Aeuda/ECE295_A3/README.md

# ECE295_A3
This repository hosts the design files, simulation results, and documentation for a sophisticated signal processing system for Team A3 in ECE295.
