Aeuda/ECE295_A3/M2/Untitled document.docx

Final schematic of band-pass Filter and Voltage Limiter:

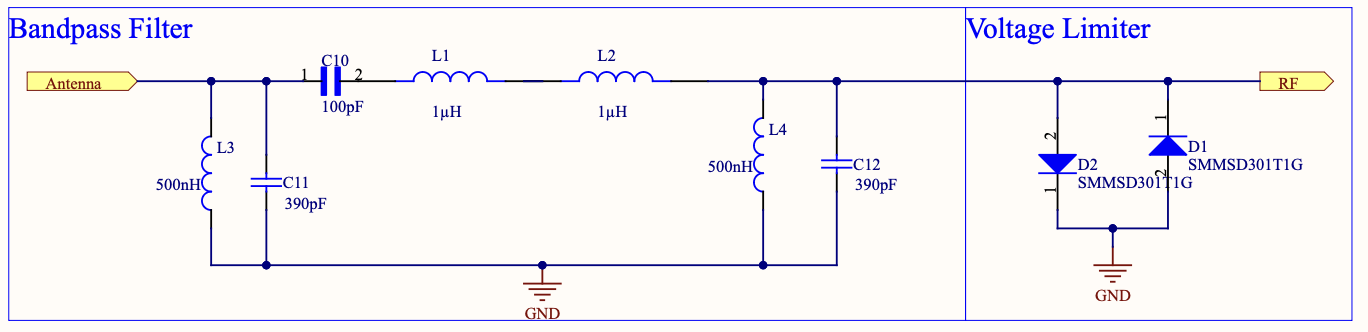
[picture p20: figure]

Final schematic of Gilbert Cell mixer and back up mixer IC for inphase and quadratuere:

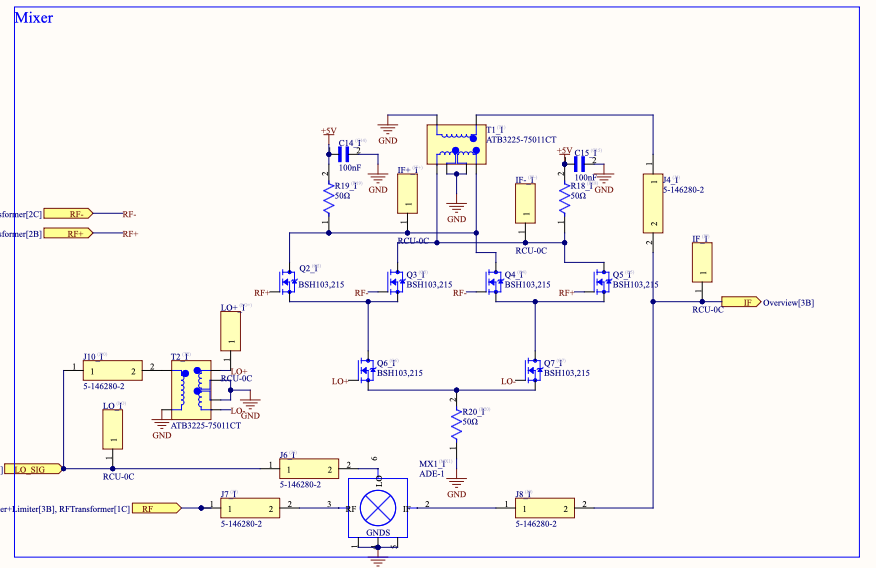
[picture p21: figure]
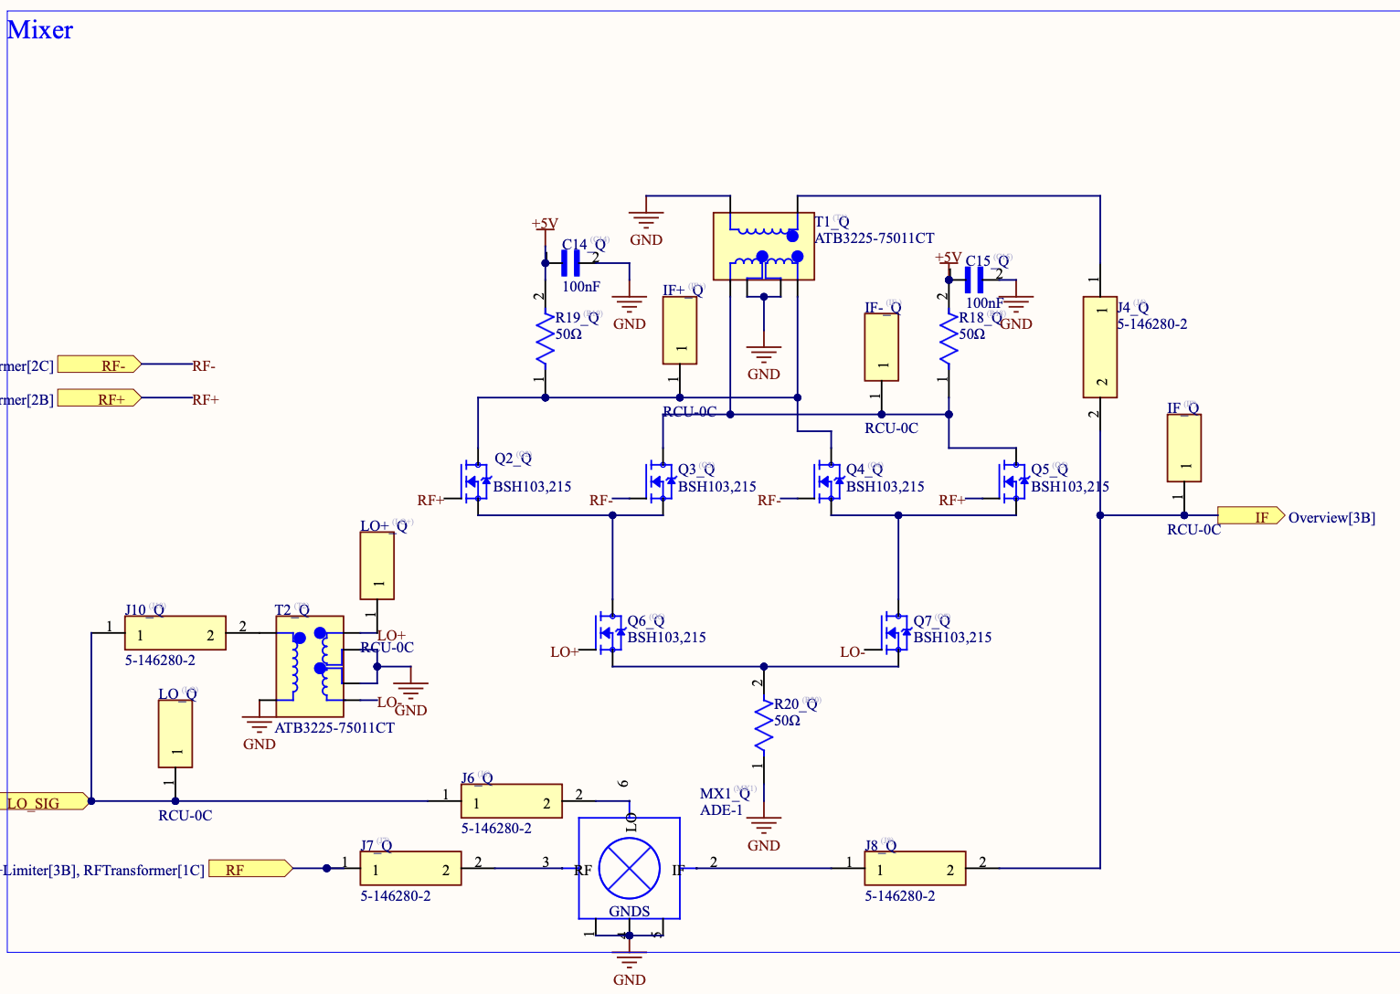
[picture p22: figure]

Final Schematic of low-pass filter and amplifier inphase and quadrature:

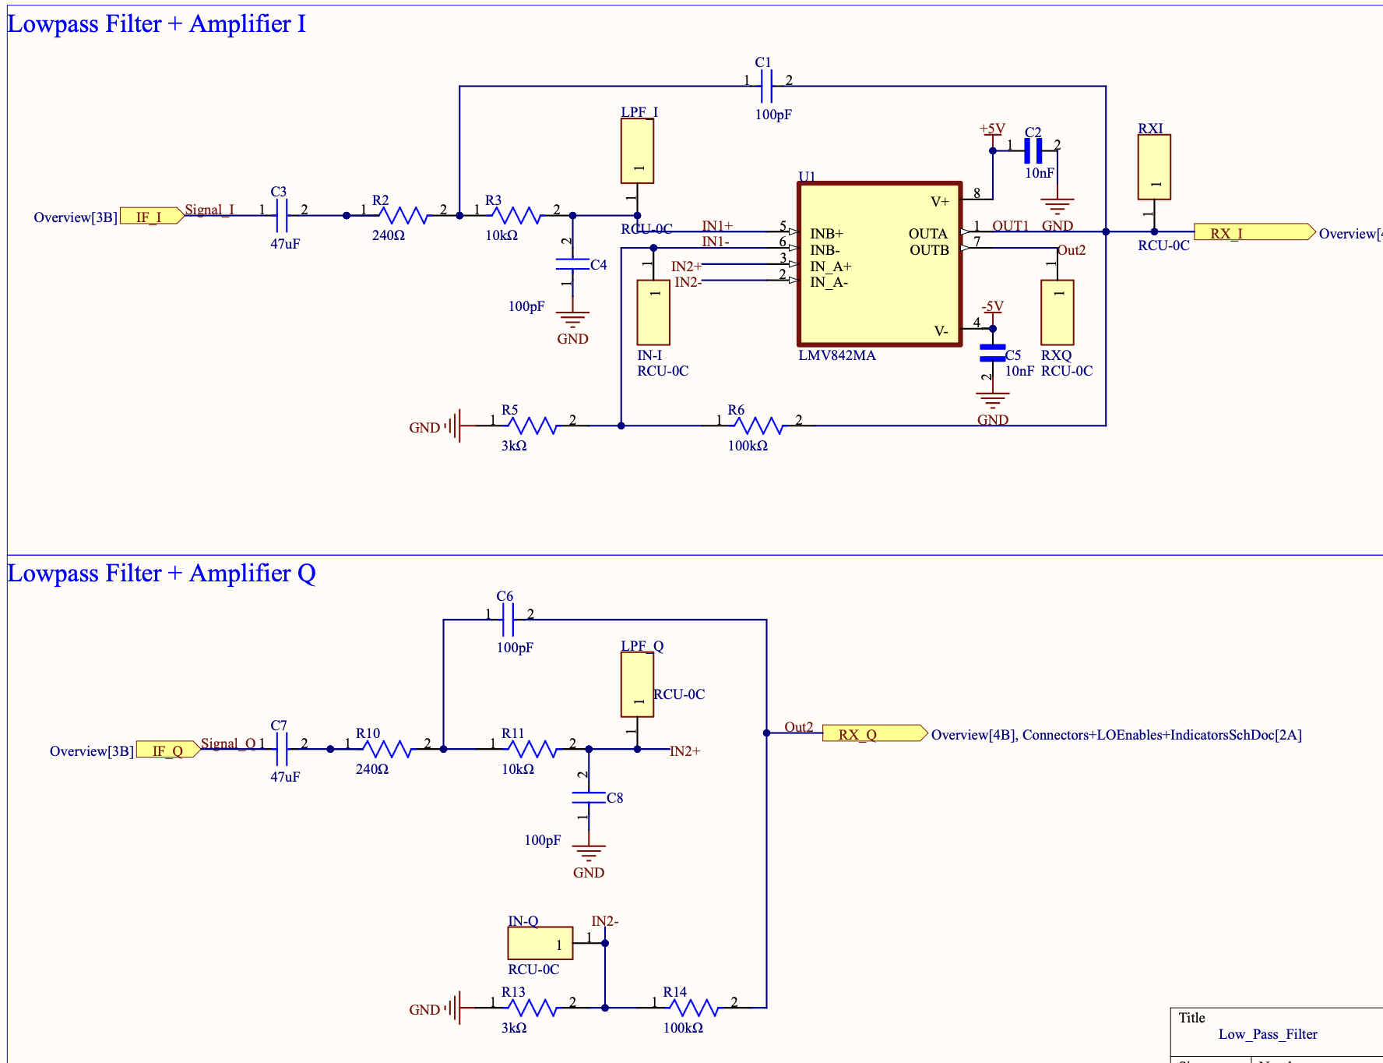
[picture p23: figure]

Final schematic of the connectors and other devices:

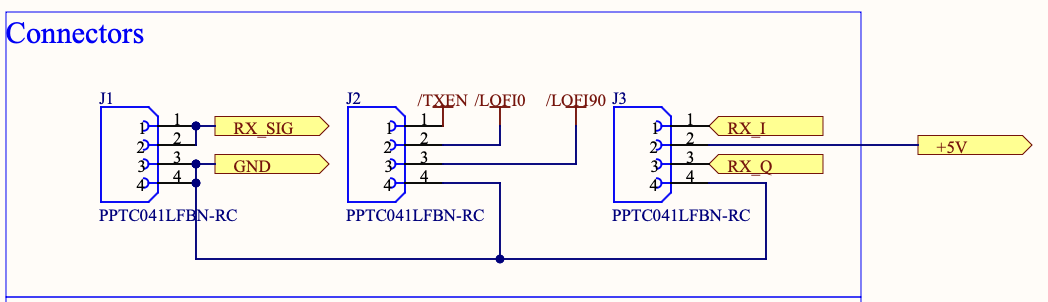
[picture p24: figure]
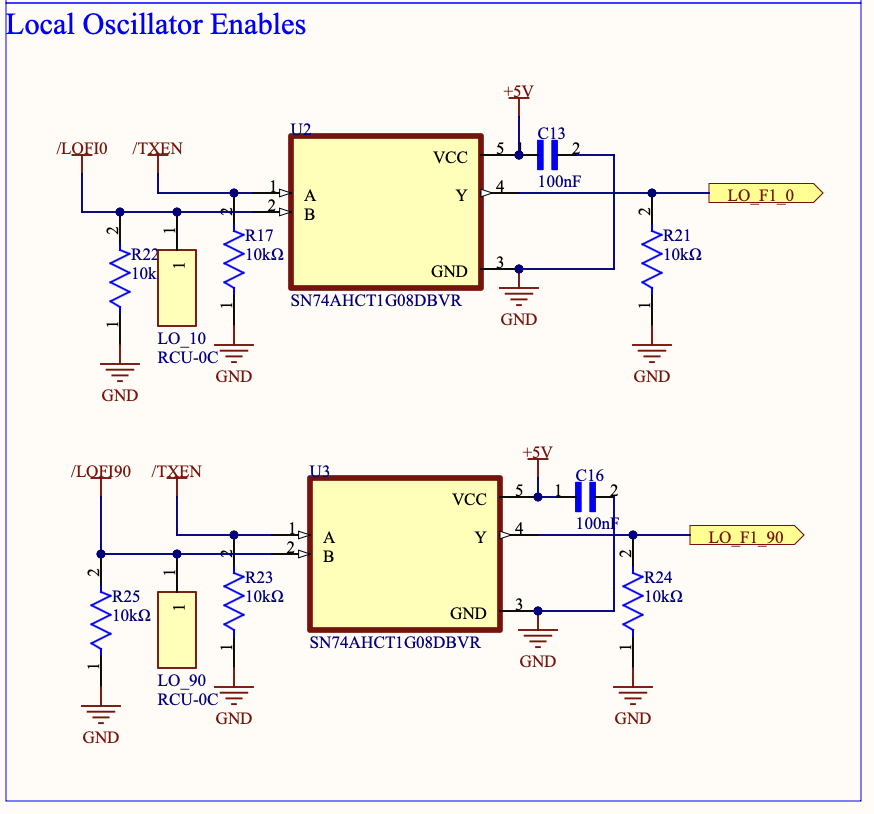
[picture p25: figure]
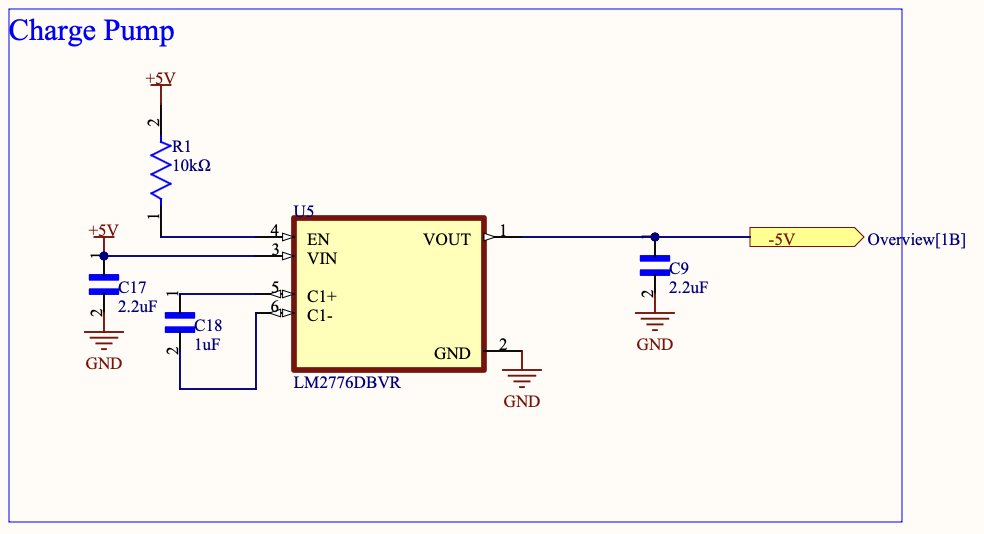
[picture p26: figure]
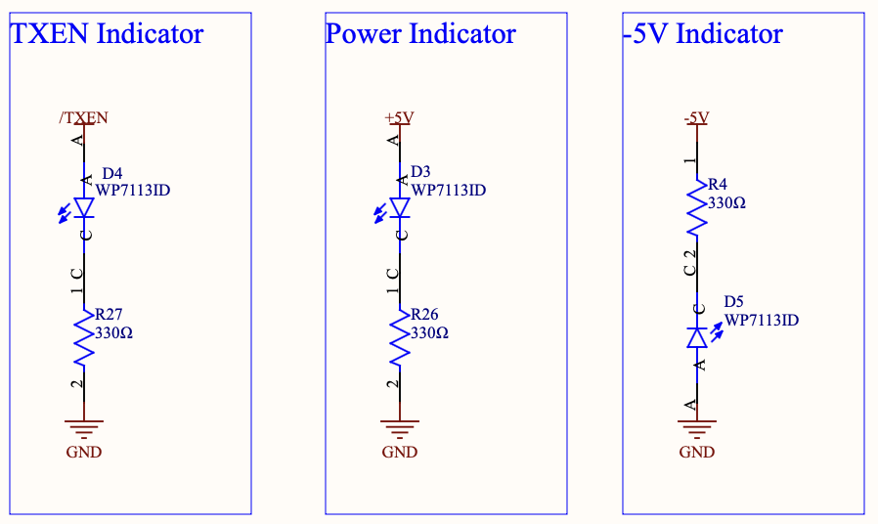
[picture p27: figure]

Final Layout design:

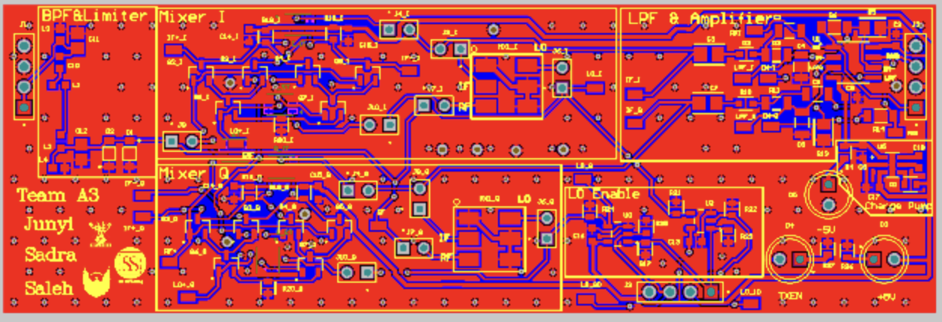
[picture p28: figure]
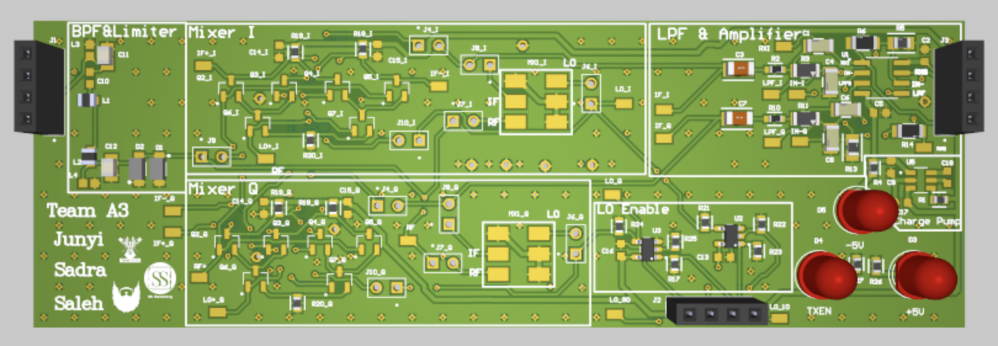
[picture p29: figure]
