Aeuda/ECE295_A3/M1/BOM.xlsx

Subsystem Section | Part Number | Component | Quantity | Unit Price | Cost | Digikey Link
Band-Pass Filter
 | HMLQ20161B-1R0MDR | 1uH Coil Inductor | 4 | $0.39 | $1.56 | https://www.digikey.ca/en/products/detail/delta-electronics-cyntec/HMLQ20161B-1R0MDR/9761420
 | CBR06C101F5GAC | 100pF Capacitor | 2 | $1.42 | $2.84 | https://www.digikey.ca/en/products/detail/kemet/CBR06C101F5GAC/7649445
 | VJ0805D391JXAQJHT | 390pF Capacitor | 4 | $0.95 | $3.80 | https://www.digikey.ca/en/products/detail/vishay-vitramon/VJ0805D391JXAQJHT/14292825
 | BRC1608TR50M6 | 500nH Coil Inductor | 4 | $0.42 | $1.68 | https://www.digikey.ca/en/products/detail/taiyo-yuden/BRC1608TR50M6/3479444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
Voltage Limiter
 | SMMSD301T1G | Schottky Diodes | 4 | $0.69 | $2.76 | https://www.digikey.ca/en/products/detail/onsemi/SMMSD301T1G/3062783
Mixer
 | BSH103,235 | NMOS | 16 | $0.56 | $8.96 | https://www.digikey.ca/en/products/detail/nexperia-usa-inc/BSH103-235/1155053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
 | ADE-1+ | RF mixer | 3 | $7.49 | $22.47 | https://www.digikey.ca/en/products/detail/mini-circuits/ADE-1/13927959
 | ATB3225-75011CT-T001 | transformer | 5 | $2.65 | $13.25 | https://www.digikey.ca/en/products/detail/tdk-corporation/ATB3225-75011CT-T001/3077895
 | CRCW060350R0FKEA | resistor 50 | 6 | $0.15 | $0.90 | https://www.digikey.ca/en/products/detail/vishay-dale/CRCW060350R0FKEA/5072766
 | CC0603KRX7R7BB104 | 0.1u cap | 4 | $0.14 | $0.56 | https://www.digikey.ca/en/products/detail/yageo/CC0603KRX7R7BB104/302822
 | 5-146280-2 | 2pin connector | 11 | $0.63 | $6.93 | https://www.digikey.ca/en/products/detail/te-connectivity-amp-connectors/5-146280-2/2275896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
 | S9001-ND | connector jumpers | 8 | $0.15 | $1.20 | https://www.digikey.ca/en/products/detail/sullins-connector-solutions/SPC02SYAN/76375?productid=76375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
Low-Pass Filter and Amplifier
 | 399-C0603X103K1RAC3316CT-ND | 10nF Capacitor | 4 | $0.57 | $2.28 | https://www.digikey.ca/en/products/detail/kemet/C0603X103K1RAC3316/10315782
 | C3216X6S0J476M160AB | 47uF Capacitor | 4 | $1.16 | $4.64 | https://www.digikey.ca/en/products/detail/tdk-corporation/C3216X6S0J476M160AB/2443489
 | 732-7887-1-ND | 100pF capacitor | 6 | $0.19 | $1.14 | https://www.digikey.ca/en/products/detail/würth-elektronik/885012008043/5453742
 | CRCW120610K0FKEA | 10kΩ Resistor | 4 | $0.15 | $0.60 | https://www.digikey.ca/en/products/detail/vishay-dale/CRCW120610K0FKEA/1176758
 | RT0603FRE07240RL | 240Ω Resistor | 4 | $0.15 | $0.60 | https://www.digikey.ca/en/products/detail/yageo/RT0603FRE07240RL/1075226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
 | RG2012P-302-B-T5 | 3kΩ Resistor | 5 | $0.32 | $1.60 | https://www.digikey.ca/en/products/detail/susumu/RG2012P-302-B-T5/1240739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
 | RT1206DRE07100KL | 100kΩ Resistor | 5 | $0.15 | $0.75 | https://www.digikey.ca/en/products/detail/yageo/RT1206DRE07100KL/1082291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
 | TLV6742IDR | IC Op amp | 3 | $1.76 | $5.28 | https://www.digikey.ca/en/products/detail/texas-instruments/TLV6742IDR/11502222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
Oscillator Enables
 | 296-1113-1-ND | AND gates | 4 | $0.60 | $2.40 | https://www.digikey.ca/en/products/detail/texas-instruments/SN74AHCT1G08DBVR/276757
 | RC0603FR-0710KL | 10K resistor | 8 | $0.15 | $1.20 | https://www.digikey.ca/en/products/detail/yageo/RC0603FR-0710KL/726880
 | A106145CT-ND | testing points | 22 | $0.30 | $6.60 | https://www.digikey.ca/en/products/detail/te-connectivity-amp-connectors/RCU-0C/2366048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
 | 754-1264-ND | LEDs | 5 | $0.52 | $2.60 | https://www.digikey.ca/en/products/detail/kingbright/WP7113ID/1747663
 | 490-GCM188L81H104MA57JCT-ND | 0.1 uf caps | 4 | $0.24 | $0.96 | https://www.digikey.ca/en/products/detail/murata-electronics/GCM188L81H104MA57J/13401872
 | 311-330GRCT-ND | 330 ohm resistor | 4 | $0.15 | $0.60 | https://www.digikey.ca/en/products/detail/yageo/RC0603JR-07330RL/726769
 | S1011EC-04-ND | Connectors Male | 5 | $0.19 | $0.95 | https://www.digikey.ca/en/products/detail/sullins-connector-solutions/PRPC004SAAN-RC/2775250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
Charge Pump
 | 296-43957-1-ND | Switched cap inverter | 2 | 1.66 | 3.32 | https://www.digikey.ca/en/products/detail/texas-instruments/LM2776DBVR/5356685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
 | 490-GCM188L81H104MA57JCT-ND | 2.2uF capacitor | 4 | 0.24 | 1.2 | https://www.digikey.ca/en/products/detail/murata-electronics/GCM188L81H104MA57J/13401872
 | 311-1343-1-ND | 1uF capacitor | 2 | 0.14 | 0.28 | https://www.digikey.ca/en/products/detail/yageo/CC0603ZRY5V9BB104/2103081
 | 311-10.0KHRCT-ND | 10K resistor 0603 | 2 | 0.15 | 0.3 | https://www.digikey.ca/en/products/detail/yageo/RC0603FR-0710KL/726880
 | A121525CT-ND | 330 ohm resisotr | 2 | 0.15 | 0.3 | https://www.digikey.ca/en/products/detail/te-connectivity-passive-product/CRG0603F330R/2380765
 |  |  |  | Total | $103.63
