Aeuda/ECE295_A3/M0/M0Plot.pdf

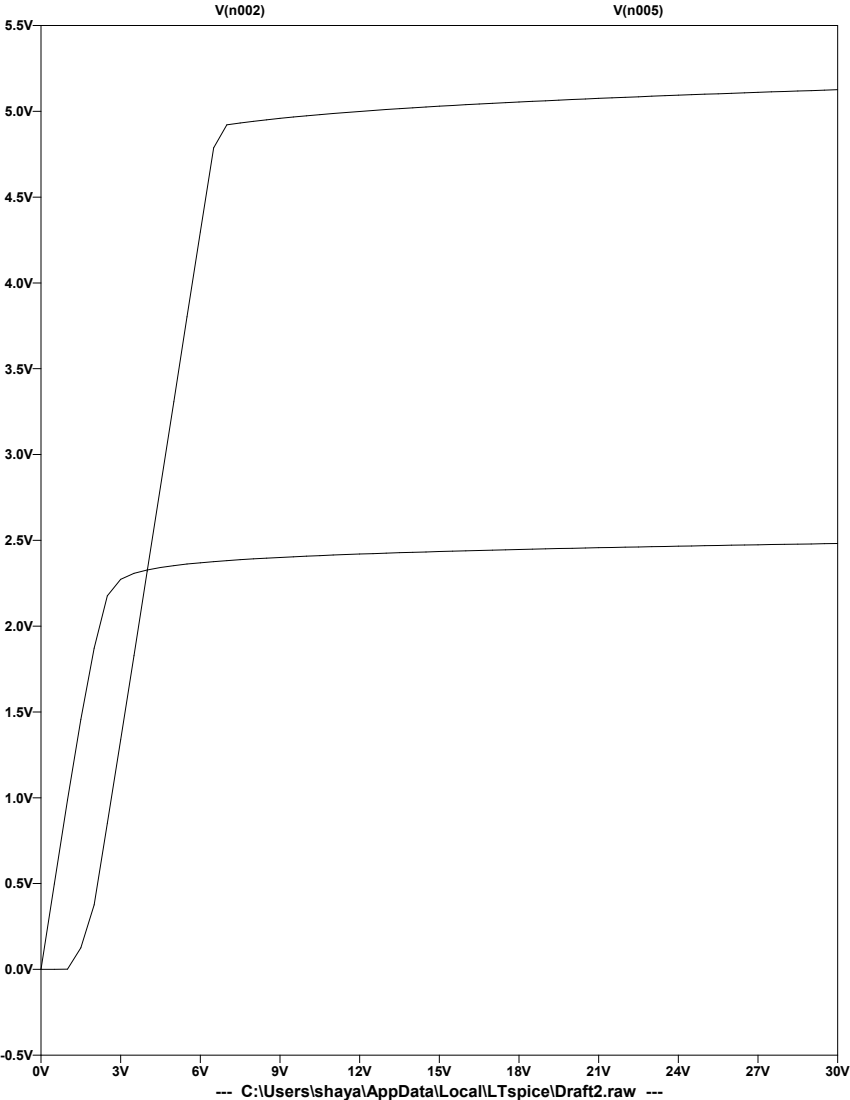
[picture p30: page 1]

--- C:\Users\shaya\AppData\Local\LTspice\Draft2.raw ---
