Aeuda/ECE295_A3/(list of files, drawings)

Other design files:
Low_pass_filter.PrjPcb
Low_pass_filter_PCB.PcbDoc
LPF/Low_pass_filter.PrjPcb
LPF/Low_pass_filter_PCB.PcbDoc
